RobertPHeller/BananaPi_M64_Portable/README

Banana Pi M64 based portable.

Includes:

Case design

5VDC to 12VDC power supply
Teensy 3.2 based thumbstick pointer w/ three buttons
