RobertPHeller/BananaPi_M64_Portable/DCDC3_7-5+12/DCDC3_7-5+12.pdf

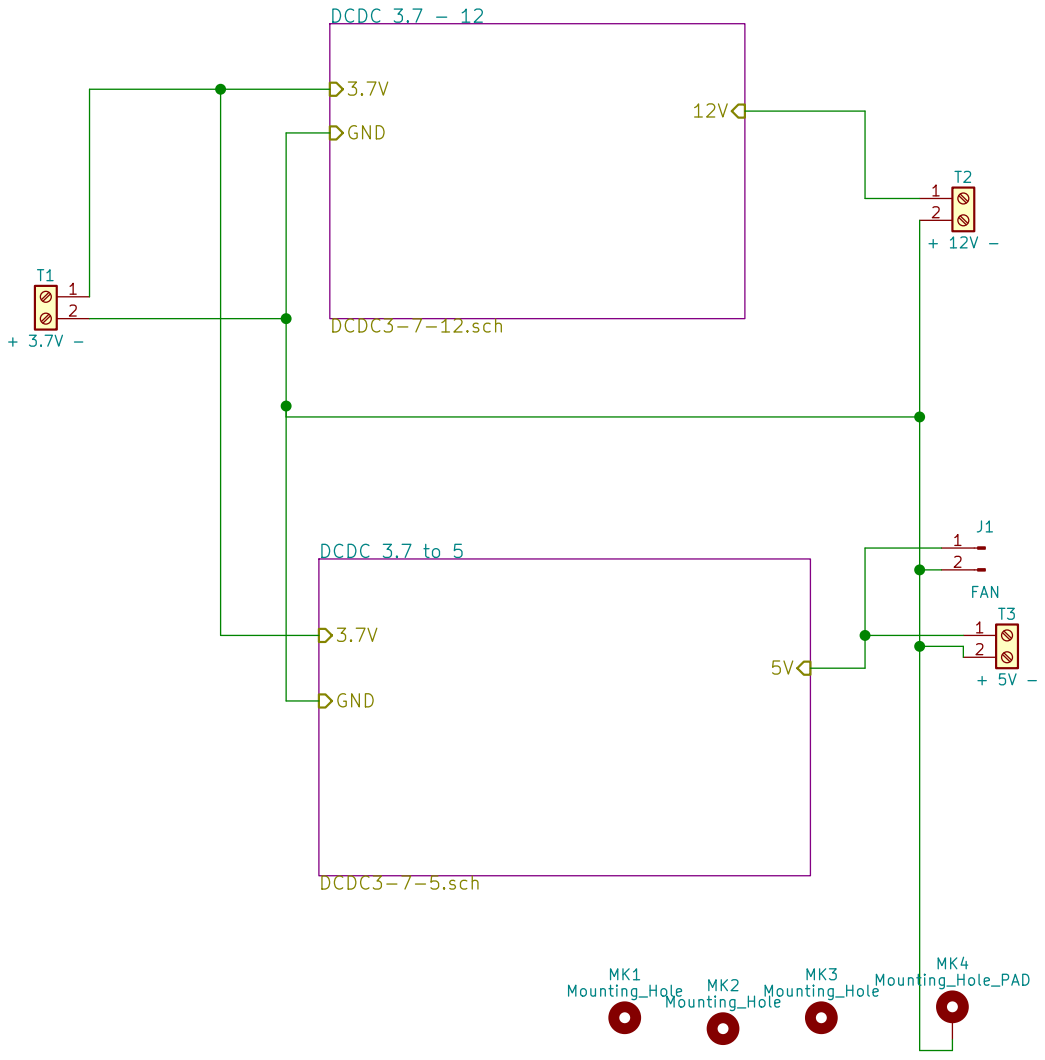
[picture p1: page 1]

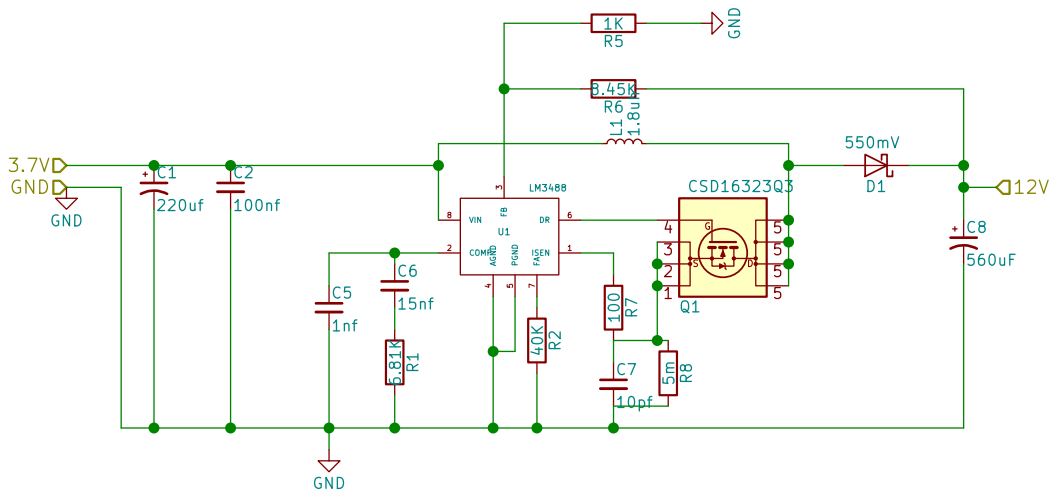
[picture p2: page 2]

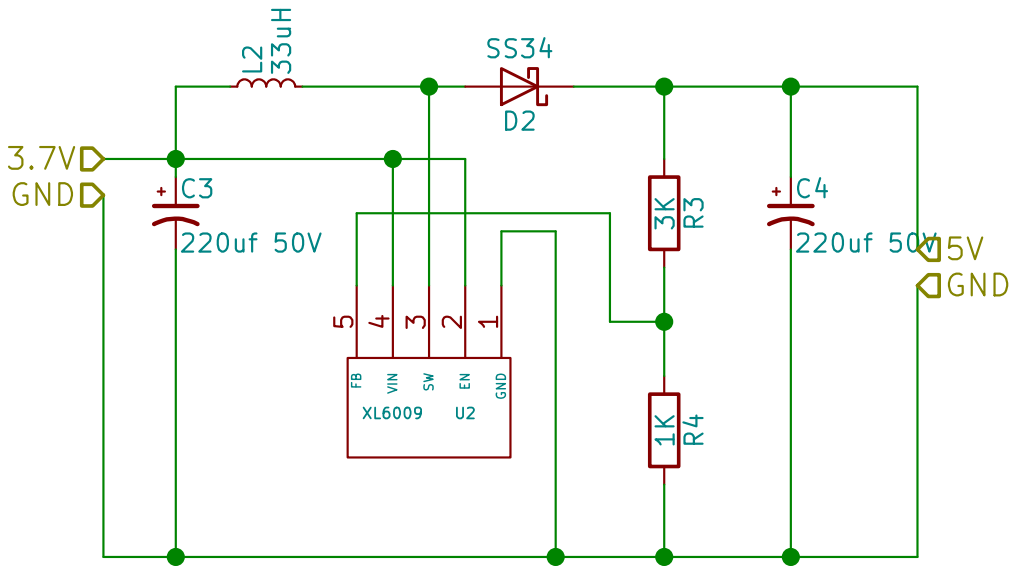
[picture p3: page 3]
