RobertPHeller/BananaPi_M64_Portable/(list of files, drawings)

Other design files:
ConsoleAdapter.fzz
TeensyJoystick/TeensyJoystick.fzz
TeensyJoystick/TeensyJoystick_protobreadboard.fzz
TeensyJoystick/TeensyJoystick_stripboard.fzz
