RobertPHeller/BananaPi_M64_Portable/DCDC3_7-5+12/DCDC3_7-5+12.kicad_pcb

## KiCad design DCDC3_7-5+12/DCDC3_7-5+12.kicad_pcb (2022-07-14)

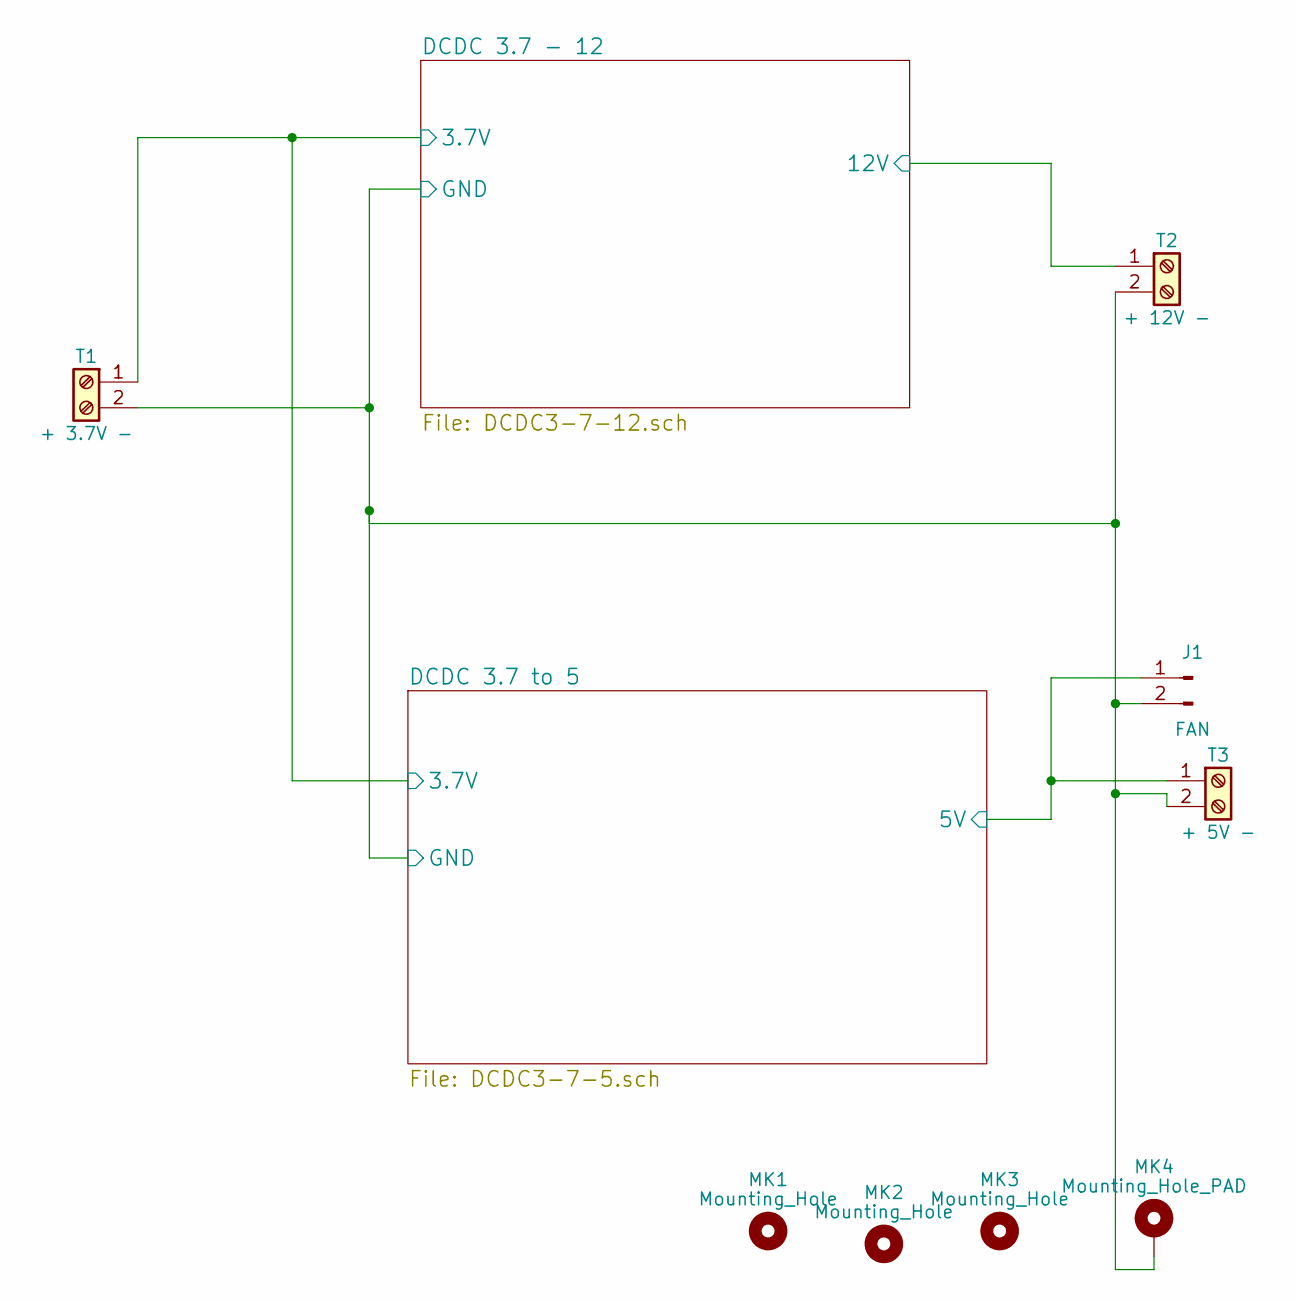
[picture p4: schematic DCDC3_7-5+12.sch, 5v and 12v (from battery) power supply]

Parts:
J1: FAN; Pin_Header_Straight_1x02_Pitch2.54mm
MK1, MK2, MK3: Mounting_Hole; MountingHole_3.5mm
MK4: Mounting_Hole_PAD; MountingHole_3.5mm_Pad
T1: + 3.7V -; TerminalBlock_Pheonix_MPT-2.54mm_2pol
T2: + 12V -; TerminalBlock_Pheonix_MPT-2.54mm_2pol
T3: + 5V -; TerminalBlock_Pheonix_MPT-2.54mm_2pol

Connections:
/DCDC 3.7 - 12/3.7V: T1.1; also elsewhere on the board
/DCDC 3.7 - 12/12V: T2.1; also elsewhere on the board
/DCDC 3.7 to 5/5V: J1.1, T3.1; also elsewhere on the board
GND: J1.2, MK4.1, T1.2, T2.2, T3.2; also elsewhere on the board

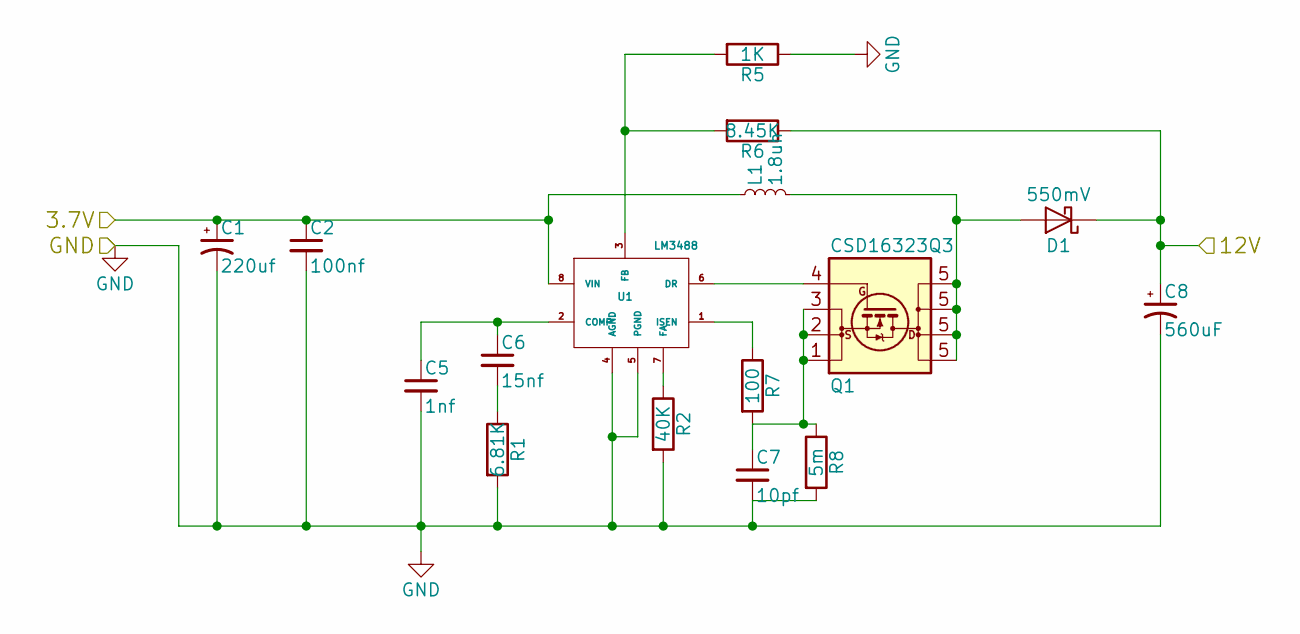
[picture p5: schematic DCDC3-7-12.sch, 5v and 12v (from battery) power supply]

Parts:
C1: 220uf; CP_Elec_5x5.7; Mouser Part Number 667-6SVPE220MW
C2: 100nf; C_0402; Mouser Part Number 81-GRM155R70J104KA1D
C5: 1nf; C_0402; Mouser Part Number 81-GRM1555C1H102JA1J
C6: 15nf; C_0805; Mouser Part Number 810-CGA4F2C0G1H153J
C7: 10pf; C_0805; Mouser Part Number 187-CL21C100CBANNNC
C8: 560uF; CP_Elec_10x10.5; Mouser Part Number 667-20SVPF560M
D1: 550mV; D_SMC; Mouser Part Number 241-SK54_R1_00001
L1: 1.8uh; INDM5564X32N; Mouser Part Number 994-XAL6030-182MEC
Q1: CSD16323Q3; Q3; Mouser Part Number 595-CSD16323Q3
R1: 6.81K; R_0402; Mouser Part Number 71-CRCW0402-6.81K-E3
R2: 40K; R_0805; Mouser Part Number 71-CRCW080540K0FKEA
R5: 1K; R_0402; Mouser Part Number 71-CRCW0402-1.0K
R6: 8.45K; R_0402; Mouser Part Number 71-CRCW0402-8.45K-E3
R7: 100; R_0402; Mouser Part Number 71-CRCW0402100RFKEDC
R8: 5m; R_0612; Mouser Part Number 71-WFCP06125L000FE66
U1: LM3488; TSSOP-8_3x3mm_Pitch0.65mm; Mouser Part Number 926-LM3488MM

Connections:
/DCDC 3.7 - 12/3.7V: C1.1, C2.1, L1.1, U1.8 (VIN); also elsewhere on the board
/DCDC 3.7 - 12/12V: C8.1, D1.1 (K), R6.1; also elsewhere on the board
GND: C1.2, C2.2, C5.2, C7.2, C8.2, R1.2, R2.2, R5.1, R8.2, U1.4 (AGND), U1.5 (PGND); also elsewhere on the board
unnamed: C5.1, C6.1, U1.2 (COMP)
unnamed: C6.2, R1.1
unnamed: C7.1, Q1.1 (S), Q1.2 (S), Q1.3 (S), R7.2, R8.1
unnamed: D1.2 (A), L1.2, Q1.5 (D)
unnamed: Q1.4 (G), U1.6 (DR)
unnamed: R2.1, U1.7 (FA)
unnamed: R5.2, R6.2, U1.3 (FB)
unnamed: R7.1, U1.1 (ISEN)

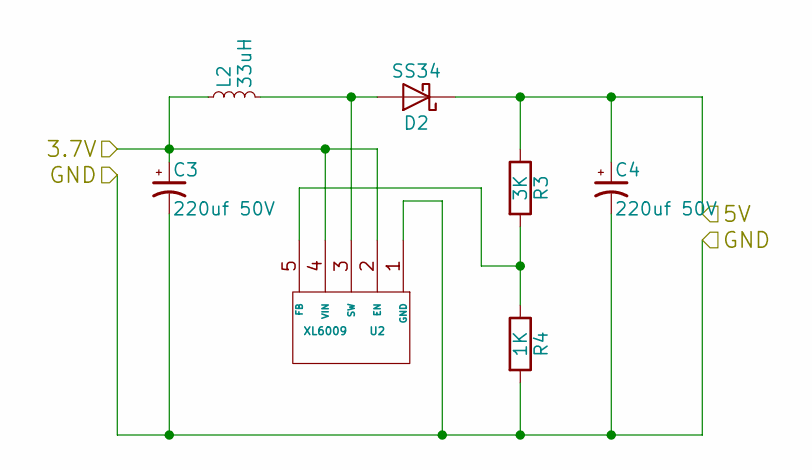
[picture p6: schematic DCDC3-7-5.sch, 5v and 12v (from battery) power supply]

Parts:
C3, C4: 220uf 50V; CP_Elec_10x10.5; Mouser Part Number 667-EEE-FK1H221V
D2: SS34; D_SMB_Handsoldering; Mouser Part Number 750-SS34BF-HF
L2: 33uH; INDPM183140X690N; Mouser Part Number 542-PM5022S-330M-RC
R3: 3K; R_0805_HandSoldering; Mouser Part Number 71-CRCW0805-3K
R4: 1K; R_0805_HandSoldering; Mouser Part Number 71-CRCW08051K00FKEAH
U2: XL6009; TO-263-5_TabPin3

Connections:
/DCDC 3.7 - 12/3.7V: C3.1, L2.1, U2.2 (EN), U2.4 (VIN); also elsewhere on the board
/DCDC 3.7 to 5/5V: C4.1, D2.1 (K), R3.1; also elsewhere on the board
GND: C3.2, C4.2, R4.2, U2.1 (GND); also elsewhere on the board
unnamed: D2.2 (A), L2.2, U2.3 (SW)
unnamed: R3.2, R4.1, U2.5 (FB)

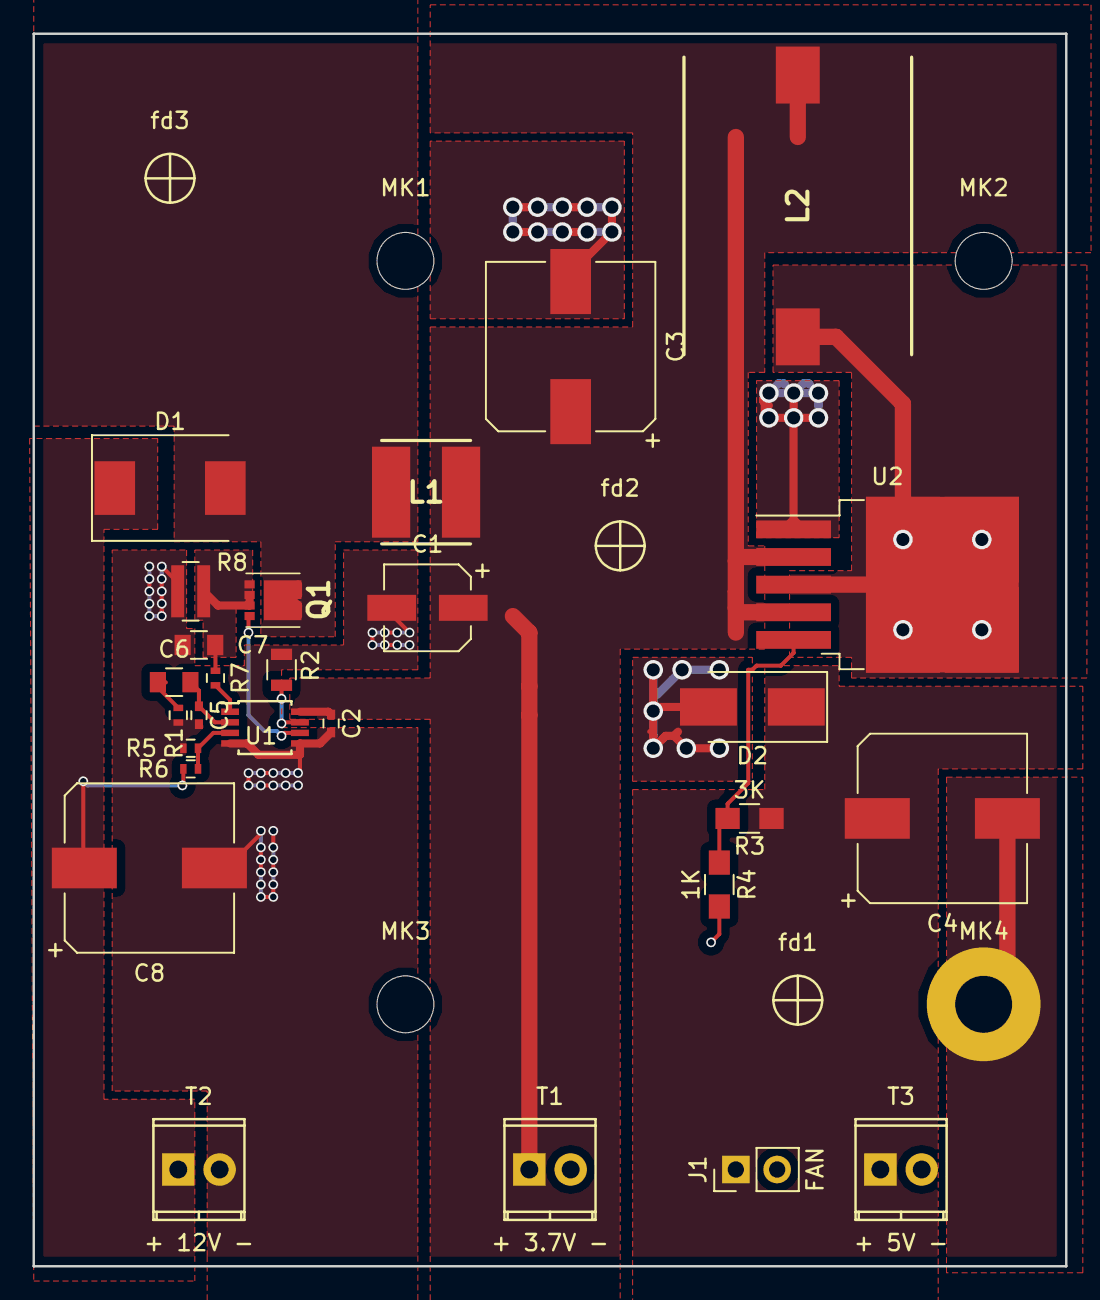
[picture p7: board DCDC3_7-5+12.kicad_pcb from above]

Board: 2 copper layers, 63.5 x 75.8 mm, 34 parts (0 on the bottom side), 14 nets.

Other parts of the board:
fd1, fd2, fd3: Fiducial_classic_Small_SilkscreenTop_Type1
