RobertPHeller/BananaPi_M64_Portable/TeensyJoystick/TeensyJoystick.kicad_pcb

## KiCad design TeensyJoystick/TeensyJoystick.kicad_pcb (2022-01-20)

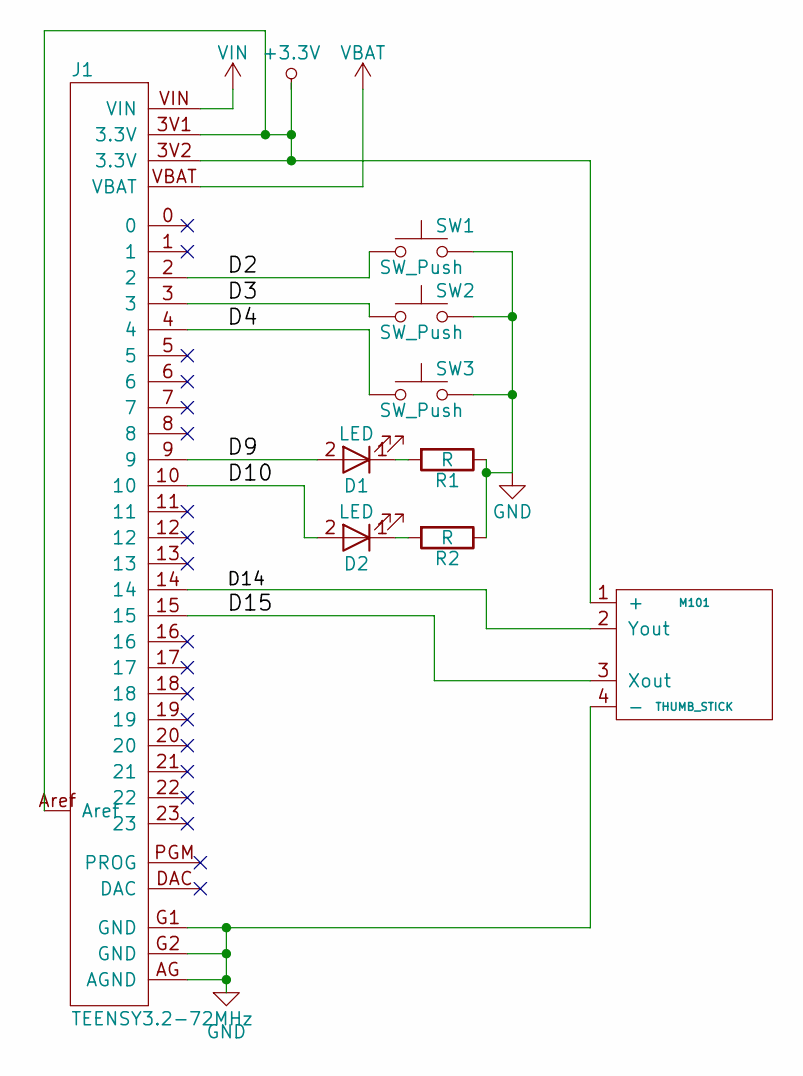
[picture p8: schematic TeensyJoystick.sch]

Parts:
D1, D2: LED; LED_D3.0mm
J1: TEENSY3.2-72MHz; TEENSY-3.2-NOSILK
M101: THUMB_STICK; MiniThumbStickBreakout
R1, R2: R; R_Axial_DIN0204_L3.6mm_D1.6mm_P7.62mm_Horizontal
SW1, SW2, SW3: SW_Push; SW_PUSH_6mm

Connections:
/D2: J1.2, SW1.1
/D3: J1.3, SW2.1
/D4: J1.4, SW3.1
/D9: D1.2 (A), J1.9
/D10: D2.2 (A), J1.10
/D14: J1.14, M101.2 (Yout)
/D15: J1.15, M101.3 (Xout)
GND: J1.AG (AGND), J1.G1 (GND), J1.G2 (GND), M101.4 (-), R1.1, R2.1, SW1.2, SW2.2, SW3.2
unnamed: D1.1 (K), R1.2
unnamed: D2.1 (K), R2.2
unnamed: J1.3V1 (3.3V), J1.3V2 (3.3V), J1.Aref, M101.1 (+)
VBAT: J1.VBAT
VIN: J1.VIN

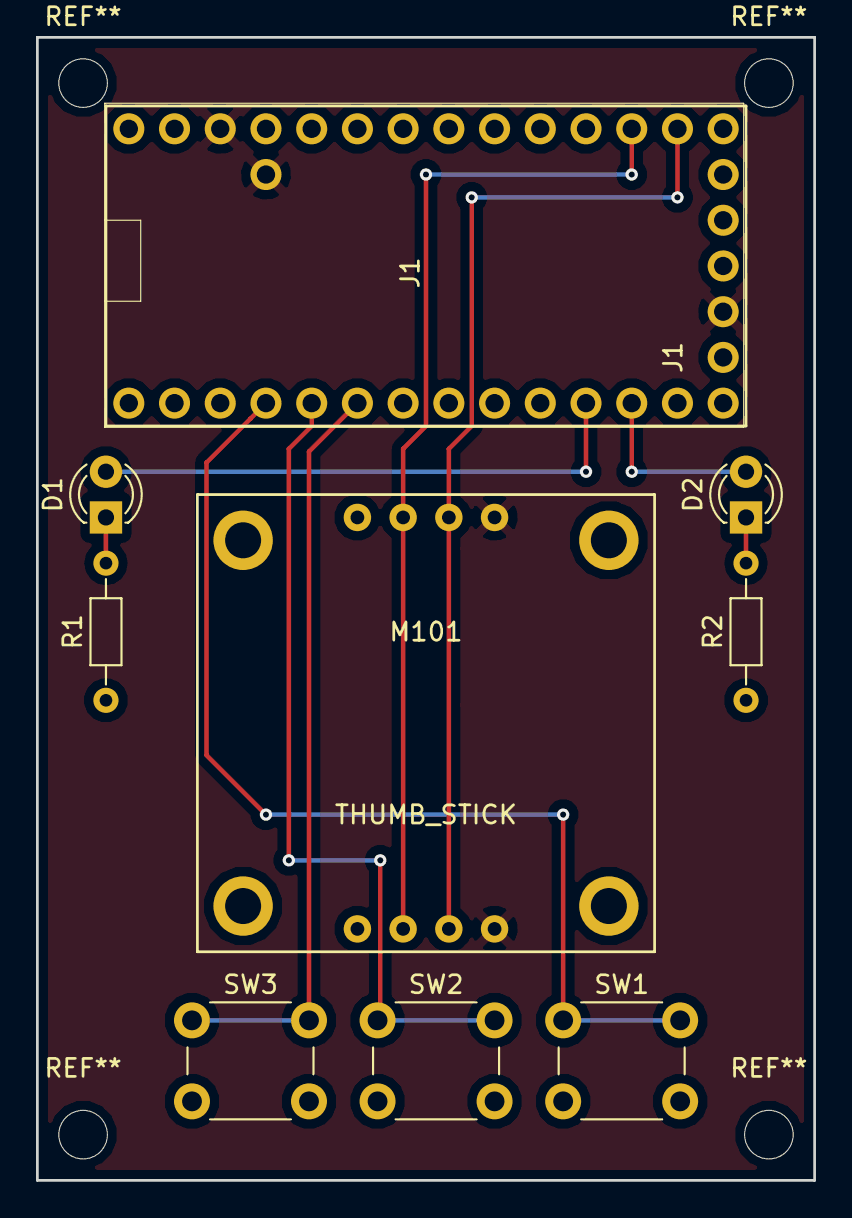
[picture p9: board TeensyJoystick.kicad_pcb from above]

Board: 2 copper layers, 43.2 x 63.5 mm, 9 parts (0 on the bottom side), 11 nets.
