RobertPHeller/BananaPi_M64_Portable/DCDC-5-12/DCDC-5-12.kicad_pcb

## KiCad design DCDC-5-12/DCDC-5-12.kicad_pcb (2020-05-04)

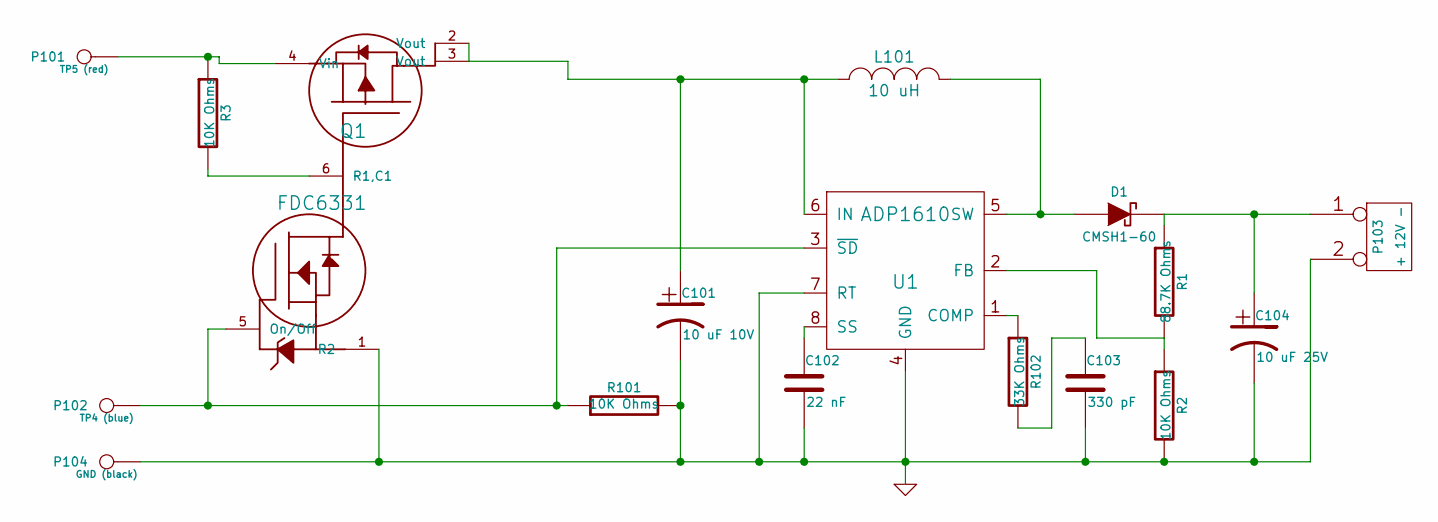
[picture p10: schematic DCDC-5-12.sch]

Parts:
C101: 10 uF 10V; Mouser Part Number 710-865090240001
C102: 22 nF; Mouser Part Number 80-C0603C223K5R
C103: 330 pF; Mouser Part Number 710-885012006082
C104: 10 uF 25V; Mouser Part Number 710-865080440002
D1: CMSH1-60; Mouser Part Number 610-CMSH1-60TR13
L101: 10 uH; Mouser Part Number 851-CDRH4D28NP-100NC
P101: TP5 (red)
P102: TP4 (blue)
P103: + 12V -
P104: GND (black)
Q1: FDC6331; Mouser Part Number 512-FDC6331L
R1: 88.7K Ohms; Mouser Part Number 652-CR0603FX-8872ELF
R2: 10K Ohms; Mouser Part Number 652-CR0603AFX1002EAS
R3, R101: 10K Ohms; Mouser Part Number 71-CRCW060310K0JNEBC
R102: 33K Ohms; Mouser Part Number 71-CRCW060333K0JNEB
U1: ADP1610; Mouser Part Number 584-ADP1610ARMZ-R7

Connections:
GND: C101.2, C102.2, C103.2, C104.2, P103.2 (PM), P104.1, Q1.1 (R2), R2.2, R101.2, U1.4 (GND), U1.7 (RT)
unnamed: C103.1, R102.2
unnamed: R102.1, U1.1 (COMP)
unnamed: R1.2, R2.1, U1.2 (FB)
unnamed: C102.1, U1.8 (SS)
unnamed: D1.1 (A), L101.2, U1.5 (SW)
unnamed: C101.1, L101.1, Q1.2 (Vout), Q1.3 (Vout), U1.6 (IN)
unnamed: Q1.6 (R1,C1), R3.2
unnamed: C104.1, D1.2 (K), P103.1, R1.1
unnamed: P101.1, Q1.4 (Vin), R3.1
unnamed: P102.1, Q1.5 (On/Off), R101.1, U1.3 (~SD)

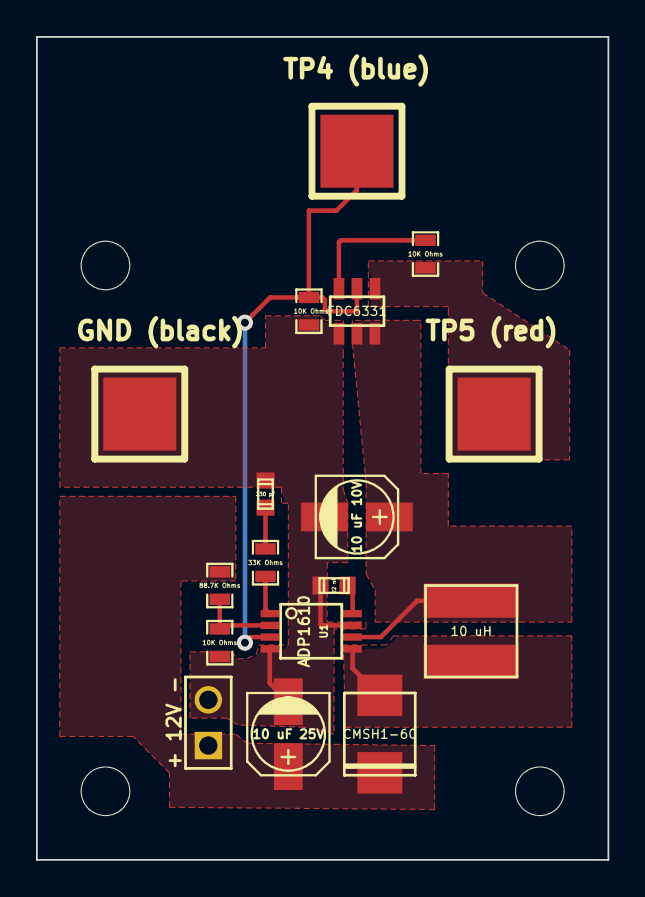
[picture p11: board DCDC-5-12.kicad_pcb from above]

Board: 2 copper layers, 31.8 x 45.7 mm, 21 parts (0 on the bottom side), 11 nets.

Other parts of the board:
MH: MountingHole_2-7mm_RevA_Date21Jun2010
MH#2, MH#3, MH#4: MountingHole_2-7mm_RevA_Date21Jun2010
