RobertPHeller/BananaPi_M64_Portable/(commit log)

2020-05-08 Integrate PS Box with main case.
2020-05-09 Fan grill holes
2020-05-15 Add LCD Screen mounting brackets, along with the screen itself.
2020-05-15 Install LCD Mounting Brackets and LCD Screen in case.
2020-05-15 LCD Bracket mounting holes.
2020-05-15 Add HDMI Converter boards.
2020-05-16 Mount HDMI Converter Boards in Case.
2020-05-16 Insert DIMs.
2020-05-18 Add thumbstick board.
2020-05-21 Battery and corner blocks.
2020-05-21 LCD Mounting bracket improvements: notch aroung speaker standoffs, SVG drawing output. Updates to SVGOutput: polygons.
2020-05-21 LCD Bracket SVG output completed.
2020-05-22 Complete Bracket drawings, with dimensions.
2020-05-23 Block drill sheets.
2020-05-26 USB=>SATA board position adjusted.
2020-05-27 Additional mounting holes.
2020-05-27 Generate gcad for 3D printed parts.
2020-05-30 Add in hinges
2020-05-31 Added PCB (with strips and mounting holes).
2020-05-31 Starting to populate the Power PCB: PS, terms, caps. done.
2020-06-01 PS PCB Completed.
2020-06-02 Moving onto the full case.
2020-06-03 Add LCD Mounting Brackets.
2020-06-03 HDMI and Cut List.
2020-06-05 Almost Done: need to do the TeensyThumbStick, PianoHinge, and complete the KeyboardShelf. Then I need to generate the drawings, etc.
2020-06-05 Added mounting holes for the hinges.
2020-06-07 Panel cut sheet done.
2020-06-08 Fix inlet body cutout error. Complete PS Box basedrawing.
    [PSBox.py]
2020-06-08 Block Drill Sheet Drawings done.
2020-06-09 Add 3D printing file (stl) creation script.
2020-06-11 First draft of TechDraw drawings of the LCD Mounting Bracket.
2020-06-11 Fine Tuning LDC Mounting Bracket Drawing.
2020-06-13 Starting on Mech. Drawings for the Power Supply Box: Base done, stalled on the Cover...
    [LCDMountingBracket.py, PSBox.py]
2020-06-14 Completed Power Supply Cover Drawing
2020-06-15 Complete Power Supply Machining Drawings
2020-06-15 Complete Teensy ThumbStick Cover Machining Drawing
2020-06-20 Completed all Revision A case design work.
2020-06-22 Code to create 3D print files (STL)
2020-06-28 A quick simple adapter for the console tty
    [ConsoleAdapter.fzz]
2020-07-07 Add grommets for fan power wires
2020-08-20 CAD Updates. Close to being done.
2020-12-15 Remove battery panel holes from bottom panel.
2021-04-18 Assorted drawing issues (missing/wrong dims).
    [PSBox.py]
2021-07-30 TeensyJoystick updates
    [TeensyJoystick.kicad_pcb, TeensyJoystick.sch, TeensyJoystick_stripboard.fzz]
2021-07-30 Working on 3D model of TeensyJoystick Box.
2021-07-30 Finish Teensy Joystick.
    [TeensyJoystick.kicad_pcb]
2021-07-31 Working on the TeensyJoystick Box.
2021-07-31 TeensyJoystick box completed.
2022-01-20 Update Teensy Joystick
2022-06-15 12V and 5V buck power supplies
    [DCDC3-7-12.sch, DCDC3-7-5.sch, DCDC3_7-5+12.kicad_pcb, DCDC3_7-5+12.sch]
2022-06-16 Add mounting holes, adjust things to accomadate mounting holes.
    [DCDC3-7-12.sch, DCDC3-7-5.sch, DCDC3_7-5+12.kicad_pcb, DCDC3_7-5+12.sch]
2022-06-16 add alternitive inductor footprint
2022-06-16 Add FAN header, minor trace updates.
    [DCDC3_7-5+12.kicad_pcb, DCDC3_7-5+12.sch]
2022-07-12 Nearly complete circuit for the AUX power supply.
    [DCDC3-7-12.sch, DCDC3-7-5.sch, DCDC3_7-5+12.kicad_pcb, DCDC3_7-5+12.sch]
2022-07-14 Final version of aux 5v and 12v power supply.
    [DCDC3-7-12.sch, DCDC3-7-5.sch, DCDC3_7-5+12.kicad_pcb, DCDC3_7-5+12.sch]
