RobertPHeller/BananaPi_M64_Portable/(notices)

Notices in the files:
3DModel/PSBox.py:
This program is free software; you can redistribute it and/or modify
it under the terms of the GNU General Public License as published by
the Free Software Foundation; either version 2 of the License, or
(at your option) any later version.
TeensyJoystick/TeensyJoystick.sch:
Released under the CERN Open Hardware License v1.2
